house4hack/nrf-glider/docs/tx_schematic.jpg

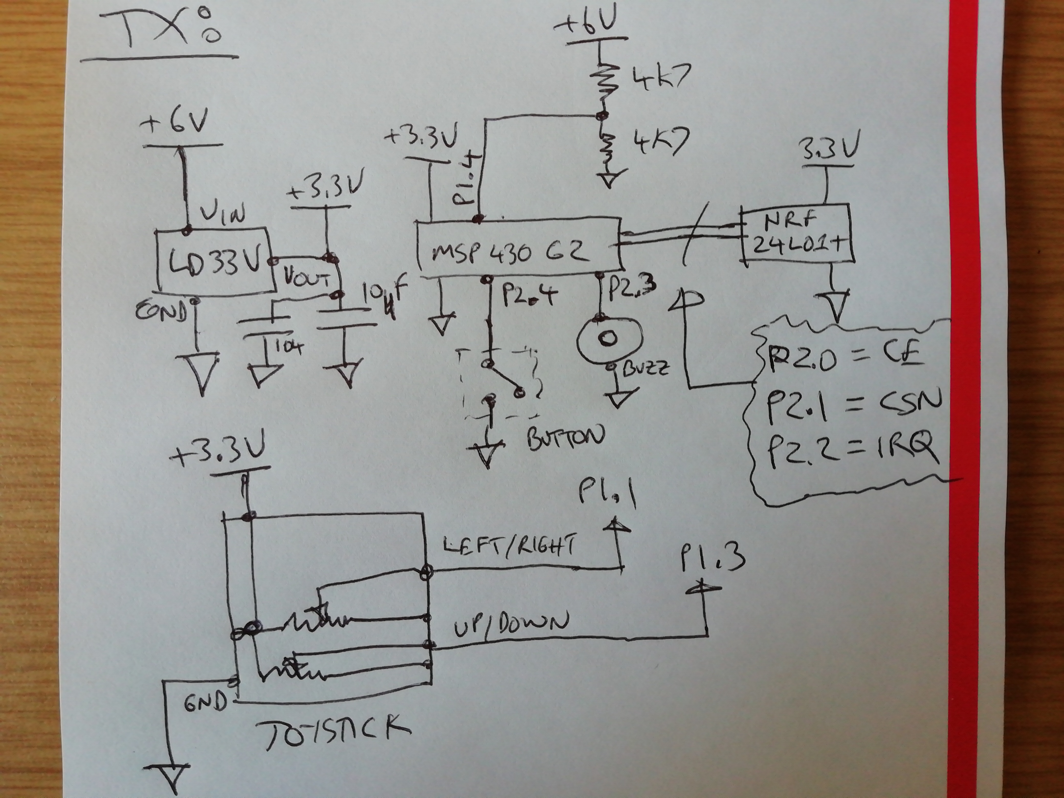
docs/tx_schematic.jpg
