house4hack/nrf-glider/docs/rx_schematic.jpg

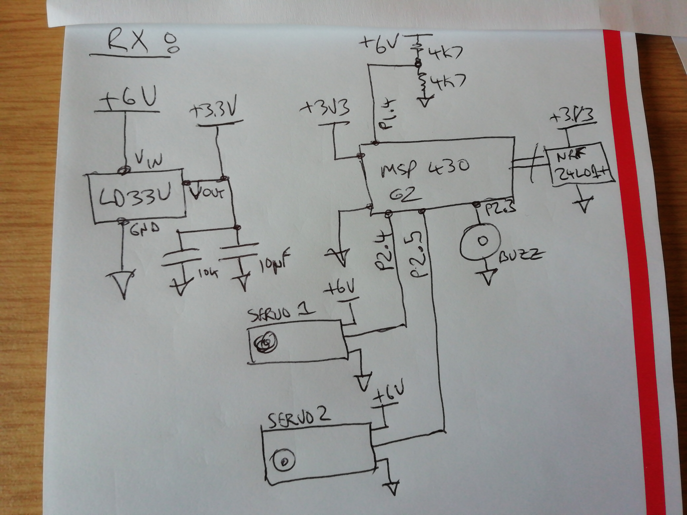
docs/rx_schematic.jpg
