house4hack/nrf-glider/docs/dAzi60/README.md

# dAzi 60

Layout files from https://www.rcgroups.com/forums/showthread.php?301997-The-Free-Slope-Soarer-Plans-Thread/page8
