house4hack/nrf-glider/docs/nrf_glider/glider_mcu-F.Cu.pdf

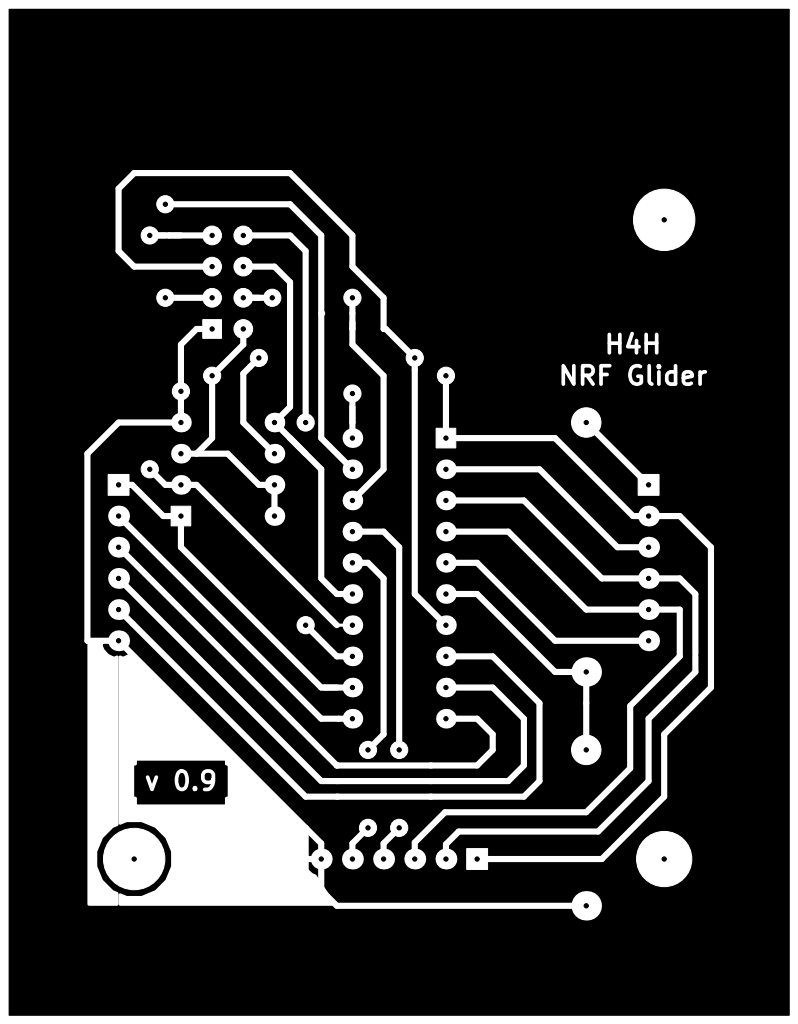
[picture p3: page 1]
