house4hack/nrf-glider/docs/dAzi60/dAzi60-layout1.pdf

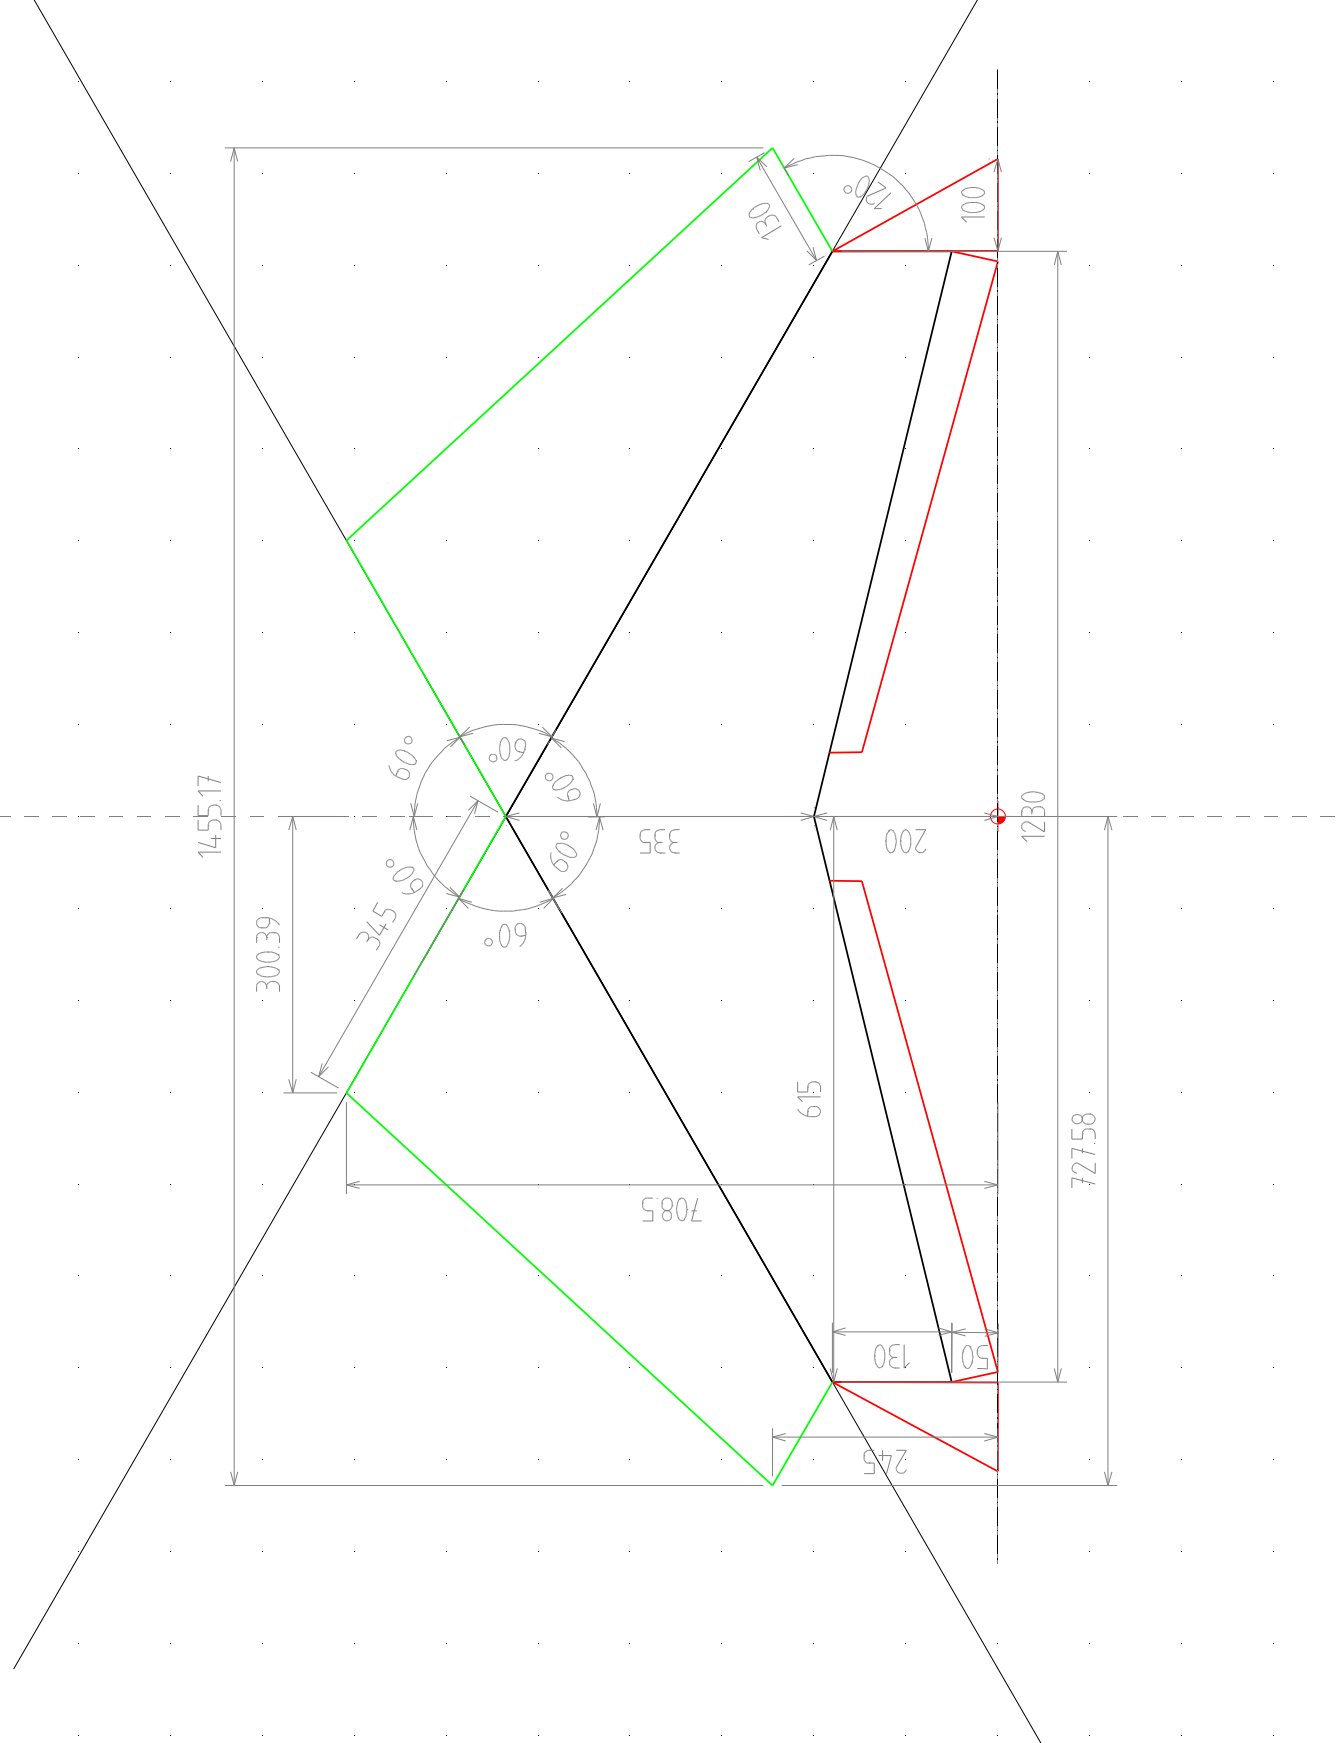
[picture p4: page 1]
