house4hack/nrf-glider/docs/dAzi60/dAzi60-layout2.pdf

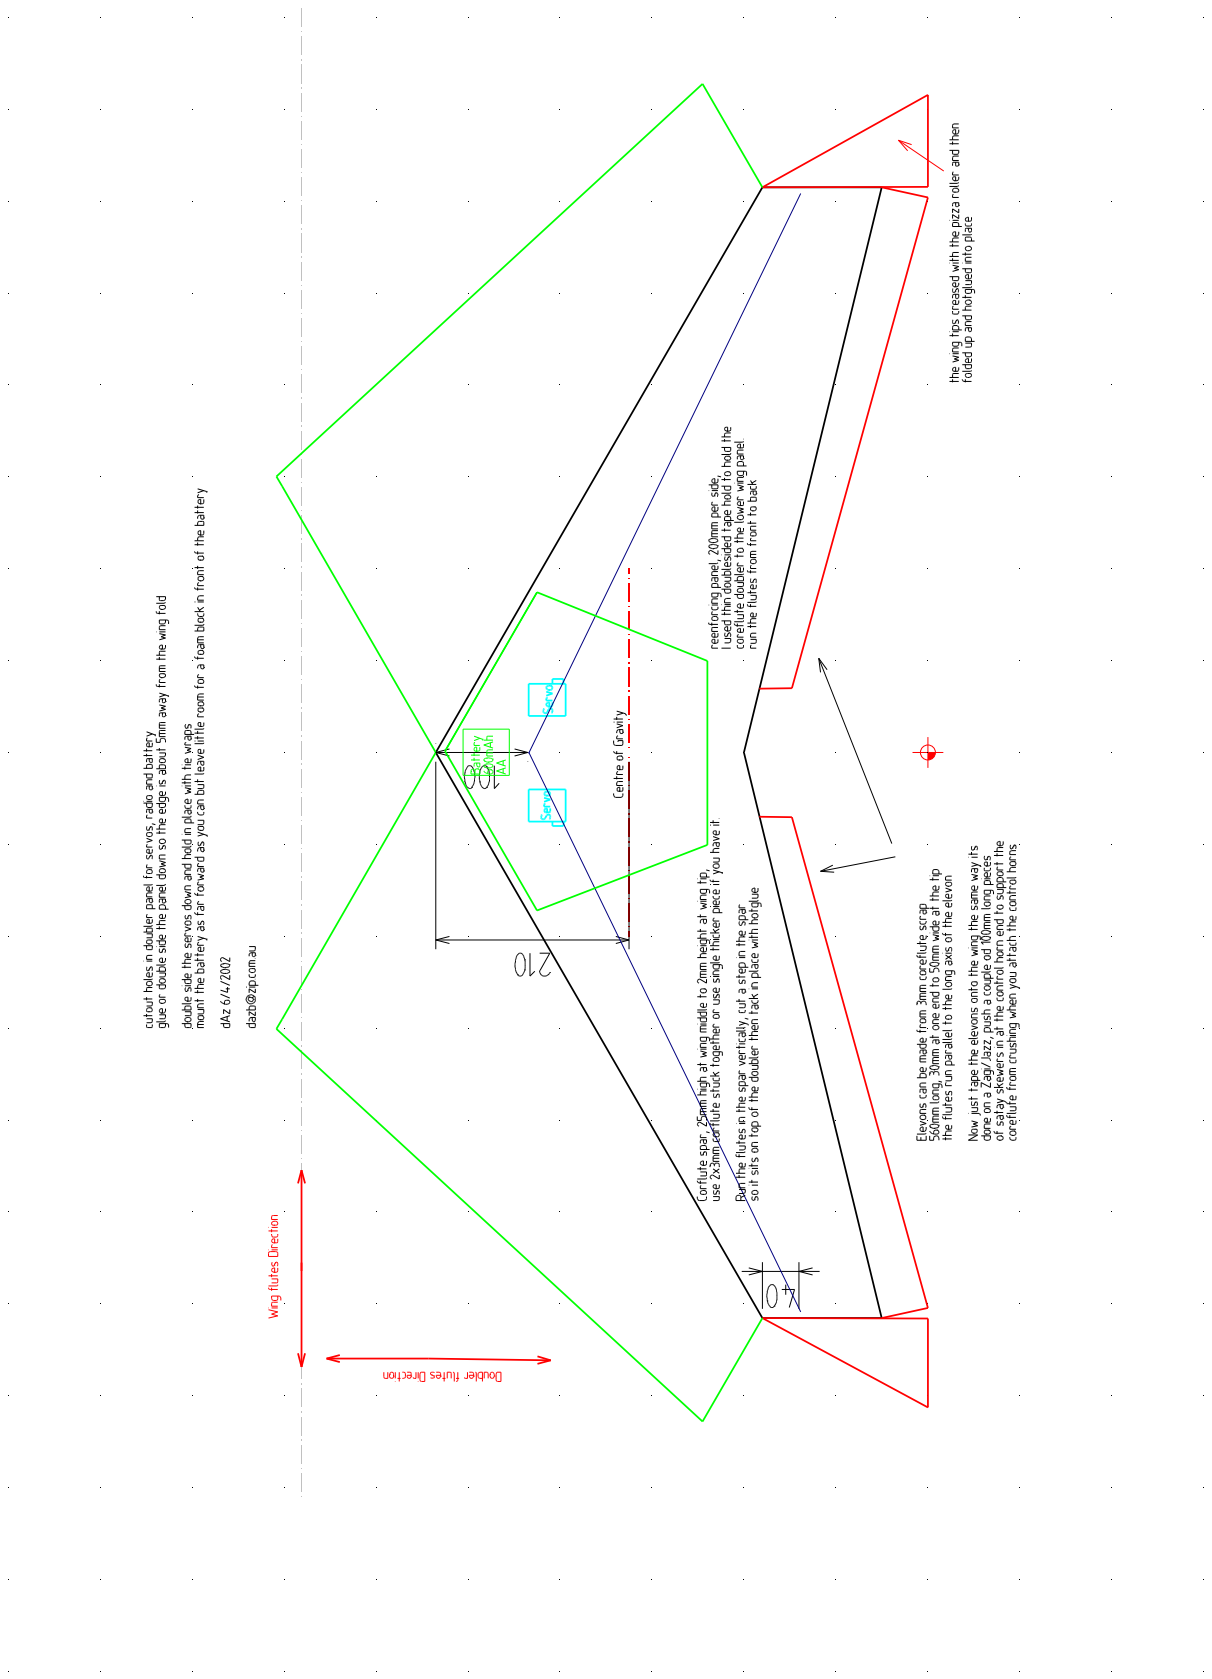
[picture p5: page 1]
