house4hack/nrf-glider/docs/nrf_glider/nrf_glider.pdf

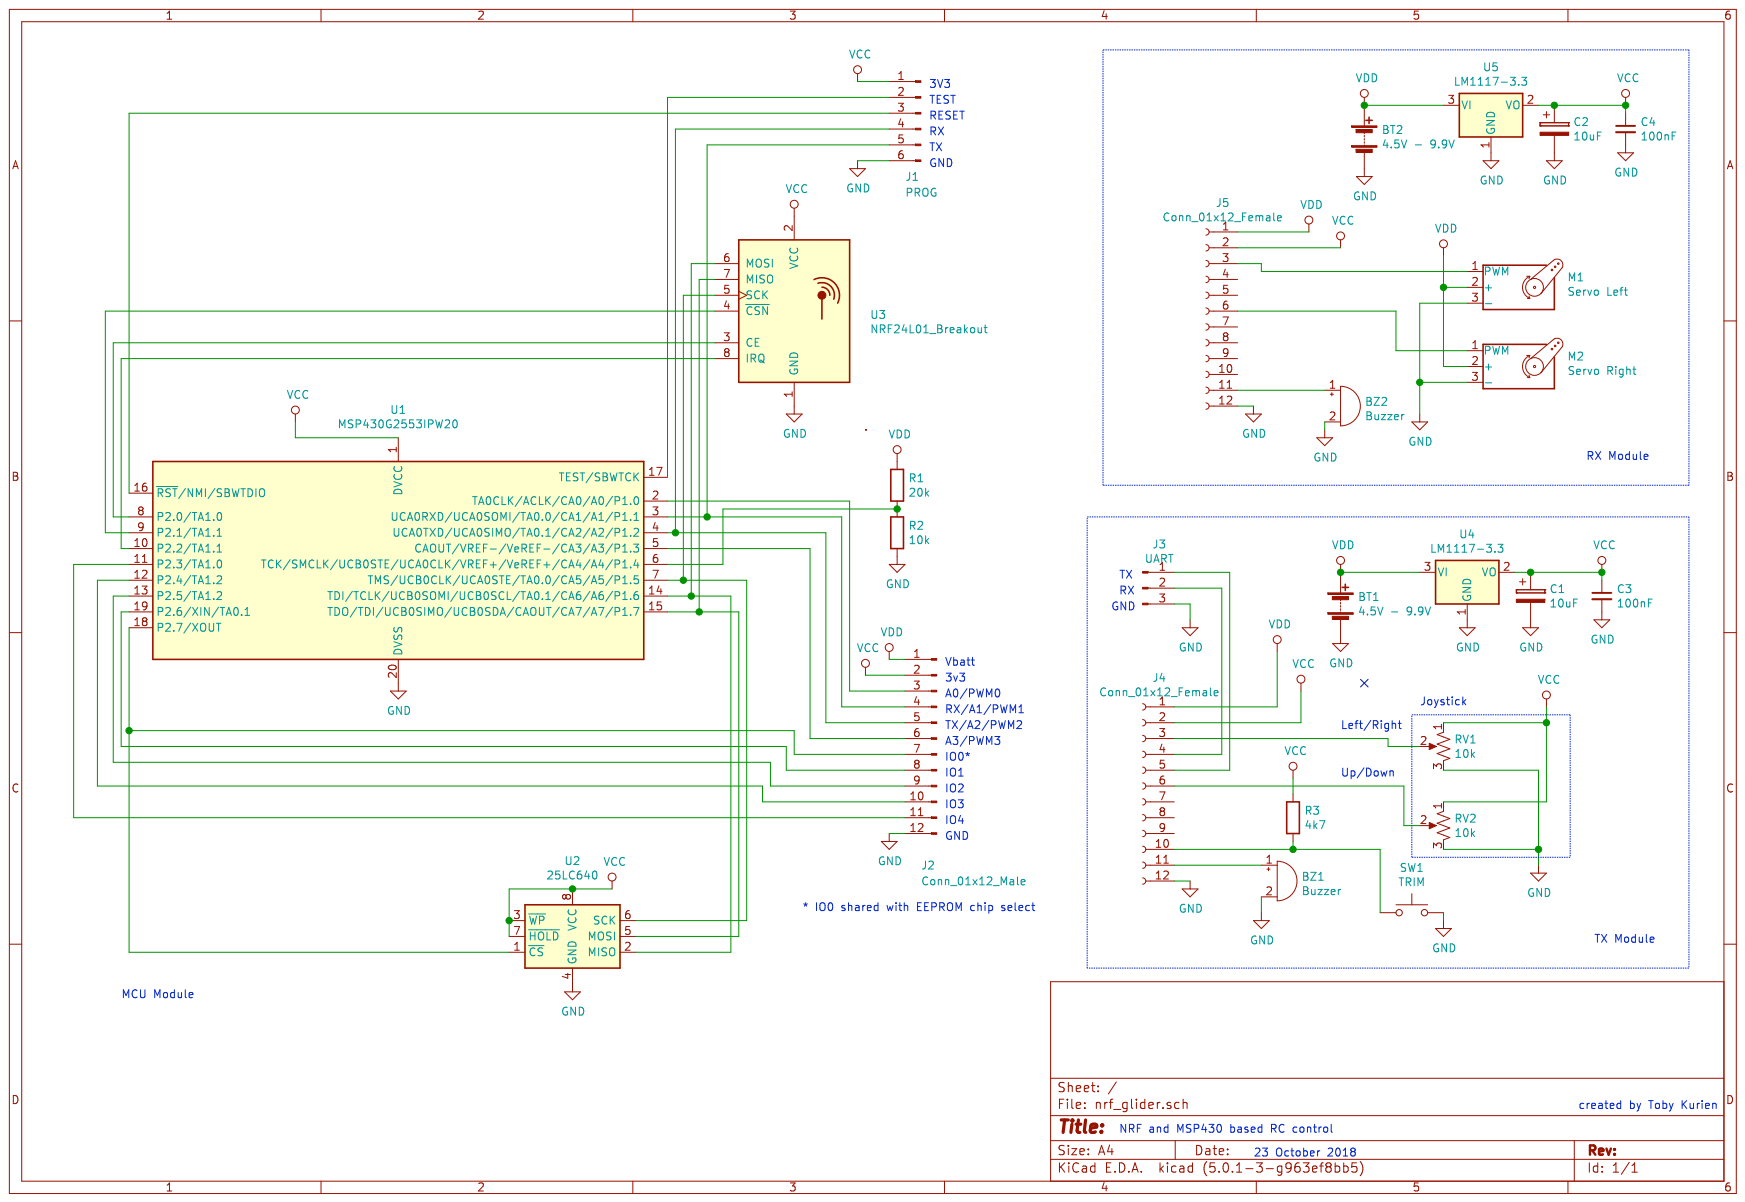
[picture p6: page 1]
