house4hack/nrf-glider/docs/nrf_glider/glider_RX_SMD.kicad_pcb

## KiCad design docs/nrf_glider/glider_RX_SMD.kicad_pcb (2019-01-08)

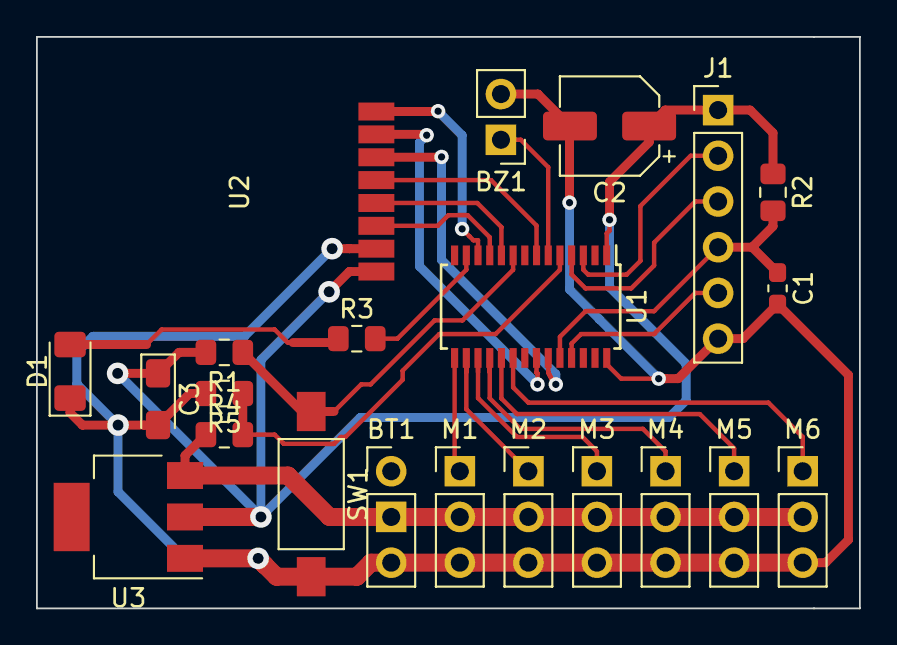
[picture p7: board glider_RX_SMD.kicad_pcb from above]

Board: 2 copper layers, 45.7 x 31.8 mm, 22 parts (0 on the bottom side), 24 nets.

Parts:
BT1: 4.5V - 7.2V; PinHeader_1x03_P2.54mm_Vertical
BZ1: Buzzer; PinHeader_1x02_P2.54mm_Vertical
C1: 10n; C_0603_1608Metric_Pad1.05x0.95mm_HandSolder
C2: 10uF; CP_Elec_5x5.8
C3: 22uF Tan; CP_EIA-3216-18_Kemet-A_Pad1.58x1.35mm_HandSolder
D1: LED; LED_1206_3216Metric_Pad1.42x1.75mm_HandSolder
J1: PROG; PinHeader_1x06_P2.54mm_Vertical
M1, M3, M4, M5, M6: Servo Left; PinHeader_1x03_P2.54mm_Vertical
M2: Servo Right; PinHeader_1x03_P2.54mm_Vertical
R1: 4k7; R_0805_2012Metric_Pad1.15x1.40mm_HandSolder
R2: 47k; R_0805_2012Metric_Pad1.15x1.40mm_HandSolder
R3: 220; R_0805_2012Metric_Pad1.15x1.40mm_HandSolder
R4: 20k; R_0805_2012Metric_Pad1.15x1.40mm_HandSolder
R5: 10k; R_0805_2012Metric_Pad1.15x1.40mm_HandSolder
SW1: Pair; SW_SPST_FSMSM
U1: MSP430G2553IPW28; TSSOP-28_4.4x9.7mm_P0.65mm
U2: NRF24L01_Breakout; NRF24L01-SMD
U3: LM1117-3.3; SOT-223

Connections:
GND: BT1.2, BZ1.2, C1.2, C2.2, C3.2, D1.1, J1.6, M1.3, M2.3, M3.3, M4.3, M5.3, M6.3, R5.2, SW1.2, U1.28, U2.1, U3.1
unnamed: BZ1.1, U1.6
unnamed: C1.1, J1.4, R2.2, U1.24
unnamed: D1.2, R3.1
unnamed: J1.2, U1.3
unnamed: J1.3, U1.4
unnamed: J1.5, U1.25
unnamed: M1.1, U1.15
unnamed: M2.1, U1.16
unnamed: M3.1, U1.17
unnamed: M4.1, U1.18
unnamed: M5.1, U1.19
unnamed: M6.1, U1.20
unnamed: R1.1, SW1.1, U1.9
unnamed: R3.2, U1.13
unnamed: R4.2, R5.1, U1.5
unnamed: U1.7, U2.5
unnamed: U1.10, U2.4
unnamed: U1.11, U2.3
unnamed: U1.12, U2.8
unnamed: U1.22, U2.7
unnamed: U1.23, U2.6
VCC: C2.1, C3.1, J1.1, R1.2, R2.1, U1.1, U2.2, U3.2
VDD: BT1.1, M1.2, M2.2, M3.2, M4.2, M5.2, M6.2, R4.1, U3.3
