house4hack/nrf-glider/docs/nrf_glider/glider_tx2.kicad_pcb

## KiCad design docs/nrf_glider/glider_tx2.kicad_pcb (2018-12-04)

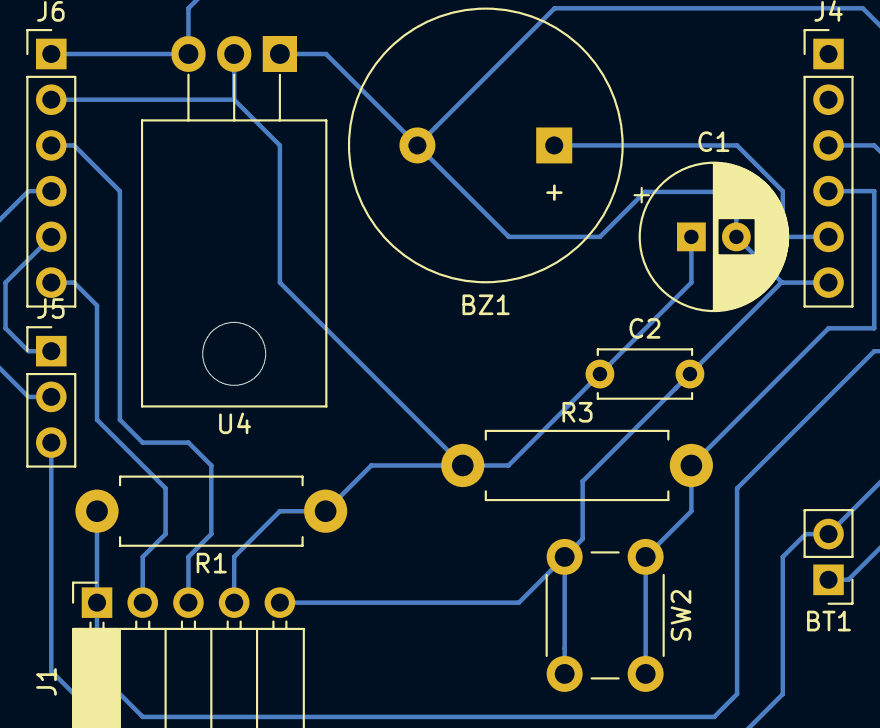
[picture p8: board glider_tx2.kicad_pcb from above]

Board: 2 copper layers, 12 parts (0 on the bottom side), 10 nets.

Parts:
BT1: 4.5V - 9.9V; PinHeader_1x02_P2.54mm_Vertical
BZ1: Buzzer; Buzzer_15x7.5RM7.6
C1: 10uF; CP_Radial_D8.0mm_P2.50mm
C2: 100nF; C_Disc_D5.0mm_W2.5mm_P5.00mm
J1: Conn_01x05_Female; PinSocket_1x05_P2.54mm_Horizontal
J4, J6: Conn_01x06_Female; PinHeader_1x06_P2.54mm_Vertical
J5: UART; PinHeader_1x03_P2.54mm_Vertical
R1, R3: 4k7; R_Axial_DIN0411_L9.9mm_D3.6mm_P12.70mm_Horizontal
SW2: TRIM; SW_PUSH_6mm_H5mm
U4: LM1117-3.3; TO-220-3_Horizontal_TabDown

Connections:
GND: BT1.2, BZ1.2, C1.2, C2.2, J1.5, J4.6, J5.3, SW2.2, U4.1
unnamed: BZ1.1, J4.5
unnamed: J1.1, J4.3, R1.2
unnamed: J1.2, J6.6
unnamed: J1.3, J6.3
unnamed: J4.4, R3.2, SW2.1
unnamed: J5.1, J6.5
unnamed: J5.2, J6.4
VCC: C1.1, C2.1, J1.4, J6.2, R1.1, R3.1, U4.2
VDD: BT1.1, J6.1, U4.3
