house4hack/nrf-glider/docs/nrf_glider/glider_mcu.kicad_pcb

## KiCad design docs/nrf_glider/glider_mcu.kicad_pcb (2018-12-04)

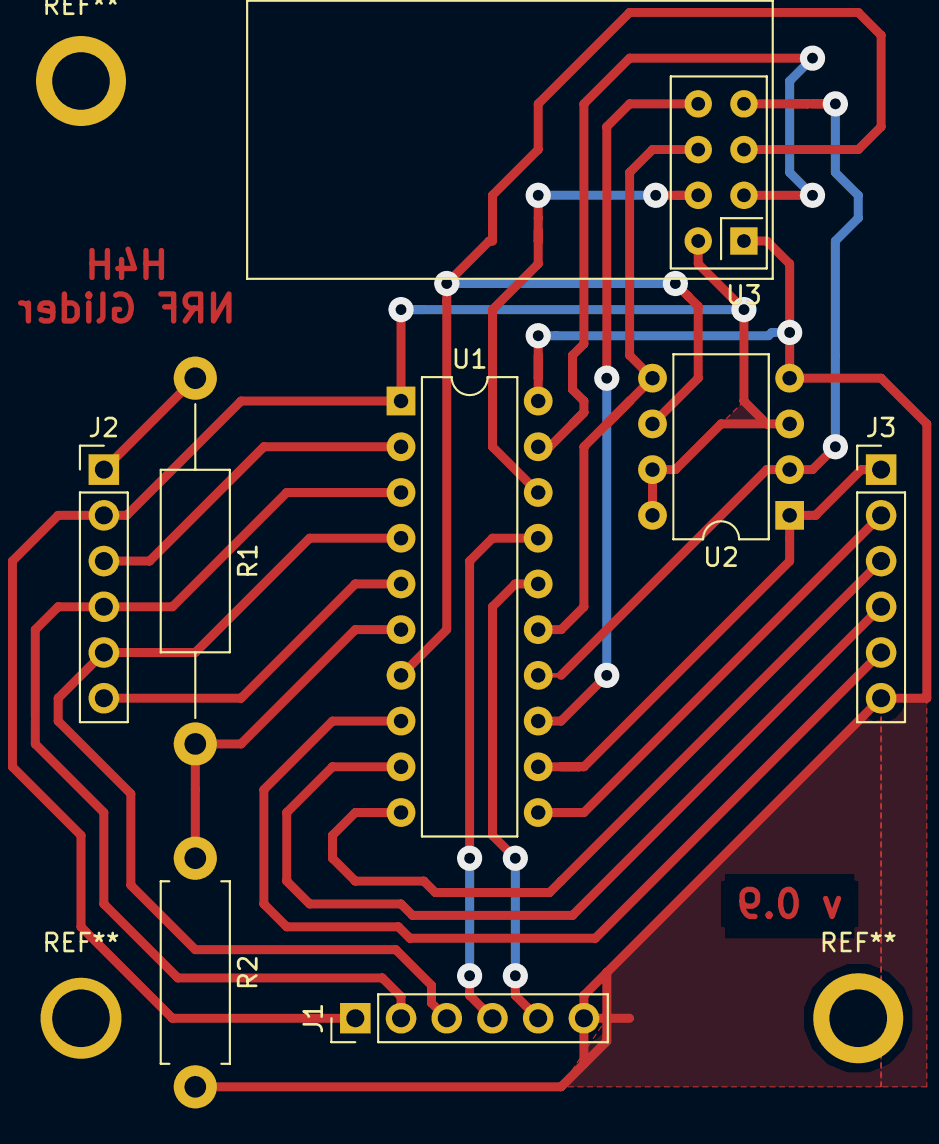
[picture p9: board glider_mcu.kicad_pcb from above]

Board: 2 copper layers, 8 parts (0 on the bottom side), 21 nets.

Parts:
J1: PROG; PinHeader_1x06_P2.54mm_Vertical
J2, J3: Conn_01x06_Male; PinHeader_1x06_P2.54mm_Vertical
R1: 20k; R_Axial_DIN0411_L9.9mm_D3.6mm_P20.32mm_Horizontal
R2: 10k; R_Axial_DIN0411_L9.9mm_D3.6mm_P12.70mm_Horizontal
U1: MSP430G2553IPW20; DIP-20_W7.62mm
U2: 25LC640; DIP-8_W7.62mm
U3: NRF24L01_Breakout; nRF24L01_Breakout

Connections:
GND: J1.6, J3.6, R2.2, U1.20, U2.4, U3.1
unnamed: J1.2, J2.4, U1.3
unnamed: J1.3, J2.5, U1.4
unnamed: J1.4, U1.17
unnamed: J1.5, U1.16
unnamed: J2.3, U1.2
unnamed: J2.6, U1.5
unnamed: J3.1, U1.12, U2.1
unnamed: J3.2, U1.11
unnamed: J3.3, U1.10
unnamed: J3.4, U1.9
unnamed: J3.5, U1.8
unnamed: R1.2, R2.1, U1.6
unnamed: U1.7, U2.6, U3.5
unnamed: U1.13, U3.8
unnamed: U1.14, U2.2, U3.7
unnamed: U1.15, U2.5, U3.6
unnamed: U1.18, U3.4
unnamed: U1.19, U3.3
VCC: J1.1, J2.2, U1.1, U2.3, U2.7, U2.8, U3.2
VDD: J2.1, R1.1
