house4hack/nrf-glider/(threads)

Thread 2 (2018-12-20):

Tx menu item to swap servos

tobykurien, 2018-12-20:
Also to reverse the servos

Closed 2019-01-22.

Thread 4 (2019-01-02):

Louder buzzer: drive it to Vdd

tobykurien, 2019-01-02:
Instead of powering the buzzer from a pin output, rather use a transistor to drive it from Vdd
