house4hack/nrf-glider/glider_tx/src/commands.h

#ifndef __COMMANDS_H__
#define __COMMANDS_H__
#include "Arduino.h"
#include "flash.h"

class Commands {
    public:
        Commands();
        void printVersion();
        void printCommandHelp(FlashData *data);
        bool handleCommands(FlashData *data);
        bool isVerbose();

    private:
        char command;
        char value[3];
        char valuePtr;
        char buf[64];
        unsigned long cmdStart;

        bool verboseMode;
        void _printCommandHelp(char command, const char* item, int value);
        bool _handleCommand(char command, int value, FlashData *data);
};

#endif
