house4hack/nrf-glider/(commit log)

2016-09-20 added battery test and actual controls, switched up to 1mbps with ack
2016-09-21 rx: return to middle if no signal, put limits on movement, battery and no signal warnings
2018-05-22 fix data rate, should be 250kbps
    [glider_rx.ino, glider_tx.ino]
2018-09-20 change frequency to 250kbps, remove annoying buzzer, gentle return-to-zero
    [glider_rx.ino, glider_tx.ino]
2018-09-21 solution for noise during debugging
    [glider_tx.ino]
2018-09-21 beep if no radio for over 2 seconds, for finding after landing
2018-10-09 rough schematics
2018-10-23 kicad schematic first draft
    [nrf_glider.kicad_pcb, nrf_glider.sch]
2018-10-23 add CS for eeprom, add UART connector on TX module
    [nrf_glider.sch]
2018-10-23 tweaks to schematic
    [nrf_glider.sch]
2018-10-23 added switch
    [nrf_glider.sch]
2018-10-24 Added some footprints
    [nrf_glider.sch]
2018-10-24 split up schematic into 3
    [glider_mcu.sch, glider_rx.sch, glider_tx.sch, nrf_glider.sch]
2018-10-24 added hierarchical sheets and labels
    [glider_mcu.sch, glider_rx.sch, glider_tx.sch, nrf_glider.sch]
2018-10-24 remove and ignore bak files
    [glider_mcu.sch, glider_rx.sch, glider_tx.sch]
2018-11-06 fixed /WP pin on EEPROM
    [glider_mcu.sch]
2018-11-06 fix nrf SPI connection
    [glider_mcu.sch]
2018-11-06 Modified pinout to connectors
    [glider_mcu.sch]
2018-11-06 Version 1 routing
    [glider_mcu.sch]
2018-11-06 Version 2 routing
    [glider_mcu.kicad_pcb]
2018-11-11 Version 2 routing PDF
    [glider_mcu.kicad_pcb]
2018-11-14 Rerouted Rx module for center buzzer
    [glider_mcu.kicad_pcb, glider_mcu.sch, glider_rx.sch, glider_tx.sch]
2018-11-14 Added a TX2 which only has a header for the joystick and no switch on psu
    [glider_tx.sch]
2019-01-08 Added a SMD version of the RX board
    [glider_RX_SMD.kicad_pcb, glider_RX_SMD.sch]
2019-01-22 wip - invert and swap axes
    [config.h, flash.cpp, glider_tx.ino]
2019-01-22 settings for axes inversion/swap
    [commands.cpp]
2019-01-22 added joystick calibration and an exponential approximation
